analuhaas/MMC/MMC_codes/arm_without_cvb/README.md

# MMC arm - without CVB

## Objectives and context

The goal of this tutorial is to test a MMC stack built with TWIST boards operation with open-loop control using NLM modulation strategy without CVB. For that, we use the two circuit structure below. $R_{dec}$ resistance is connected in parallel to the stack for circuit #2 in order to emulate negative currents discharging the modules capacitor.



As in the individual module test, the boards serves as a HB module of the MMC by programming its second leg (LEG2) to be deactivated, having the following circuit. Observe that the HIGH terminals are open (Vhigh to GND).



The NLM modulation consists of attributing levels according to the modulation signal amplitude using the function round such that the level attributed to the modulation signal is the nearest integer and its principle is represented here:



For example, if the modulation signal is 2.6, it is going to be attributed to level 3. For the MMC, the modulation signal is a sinusoidal wave, making that the NLM modulation result is a stepped wave-form as shown:



This stepped wave-form output of the NLM indicates how many modules should be connected in the stack ($N_{\left(u,l\right),p}^{on}$) according to time.

In this code, no Capacitor Voltage Balancing (CVB) algorithm is used and the choice of connected modules is given by a fixed preference order M1 > M2 > M3 > M4 > M5

## Required Hardware list

- 6 TWIST boards with SPIN
- 6 independent DC power supplies of 6 V with minimum 0.5 A
- 1 DC power supply of (48 V, 5 A)
- Protection diode (at least 100 V)
- 2 resistors of 15\ \Omega
- 5 ethernet cables
- PC 64-bits (windows or linux)
- Oscilloscope
- Current probe
- 6 BNC adaptors to differential voltage measurement

## Required Software list

- Git
- Visual Studio Code with PlatformIO

## Get tutorial code from VScode

First, we need to load the Single module test code from the OwnTech example repository version in https://github.com/analuhaas/examples 
1.	In VScode, open the folder where you previously cloned OwnTech’s github.
2.	In platformio.ini file, substitute the owntech_examples variable link by https://github.com/analuhaas/examples.git 
3.	Go to platform.io icon , go to Examples Twist under the Project Tasks tab and click on “MMC arm – no CVB”.



4.	Now you have the good code to execute the tutorial in your VScode.

## Modules hardware setup

Repeat for the 5 modules boards:

5.	Recommended for MMC use: Configure all 5 modules boards to feed the 6 V auxiliary input externally with feeder completely disconnected from the electrical circuit of the board.

- Connect an External Auxiliary DC Power Supply to the TWIST via the 6 V and DGND PINs. Make sure the External Auxiliary DC Power Supply is configured to deliver 6 V with limiting current above 0.5 A. Make sure this power supply OUTPUT IS OFF.



- Open the jumper JP5001 of the board by cutting the jumper connections using a cutter with an appropriate camera to see the area



6.	If not done yet: Test the module using the [low-frequency](https://github.com/analuhaas/MMC/blob/tutorials_updates/MMC_documentation/module_LF_test_tutorial.md) and [high-frequency](https://github.com/analuhaas/MMC/blob/tutorials_updates/MMC_documentation/module_HF_test_tutorial.md) tests.

## Stack Hardware setup

7.	Connect the boards in series using VLOW1 and GND terminals to form an MMC stack using banana cables (figure below).
8.	Connect to each module an External Auxiliary DC Power Supply to the TWIST via the 6 V and DGND PINs. Make sure the External Auxiliary DC Power Supplies are configured to deliver 6 V with limiting current above 0.5 A. Make sure these power supplies OUTPUT IS OFF (figure below).
9.	Connect the boards using ethernet cables as in the image (figure below).
10.	Connect the stack to the main DC power supply, R and Rdec resistances and diode (figure below).

!!! If using circuit#1, remove Rdec from the circuit. If using circuit #2, circuit exactly as in the image.



11.	Connect the voltage and current measurements with the oscilloscope (figure below). 



After making the connections and connecting the PC to the central controller board with the USB-C cable, you should have something like this:

stack_test_hardware_ready

12.	Configure your Oscilloscope with PicoScope (tutorial using PicoScope 4444)

a.	Make sure it acquires the following measurements:

i.	Modules capacitor voltages (Vhigh to GND).

ii.	Stack current.

iii.	Stack voltage.

b.	Use a 10 s/div configuration with sampling interval around 1 µs (x5 smaller than critical task period)



c.	Configure it to trigger when the stack voltage rises up to 2 V.



## Executing the tutorial Stack test

13.	Get the correct test code using “MMC arm – no CVB”  button.
14.	Optional: Change the test parameters to have a more specific test:

  a.	In code: NLM frequency, number of modules.

  b.	In circuit: Number of modules, resistance values (to reduce or increase current), DC supply voltage.

15.	Repeat to all 5 module boards M1, M2, M3, M4, M5:
  
  a.	Connect the board to the PC via a USB-C cable.
  
  b.	Build  and Upload  the code main.cpp into the board.
  
  c.	Open the serial monitor and copy the board ID to the identification list in the code according to its function in the stack

```
  /* -------------- BOARD IDENTIFICATION ----------------------- */

  constexpr uint32_t UID_MMC_LEAD_BOARD = 0x002B002A;
  
  constexpr uint32_t UID_MMC_SM1_BOARD = 0x00330054;
  
  constexpr uint32_t UID_MMC_SM2_BOARD = 0x0033004B;
  
  constexpr uint32_t UID_MMC_SM3_BOARD = 0x00330049;
  
  constexpr uint32_t UID_MMC_SM4_BOARD = 0x0033004C;
  
  constexpr uint32_t UID_MMC_SM5_BOARD = 0x0031001B;
  
  constexpr uint32_t UID_MMC_SM6_BOARD = 0x11118888;
  
  constexpr uint32_t UID_MMC_SM7_BOARD = 0x11119999;
  
  constexpr uint32_t UID_MMC_SM8_BOARD = 0x1111AAA0;
  
  constexpr uint32_t UID_MMC_SM9_BOARD = 0x1111BBB1;
  
  constexpr uint32_t UID_MMC_SM10_BOARD = 0x1111CCC2;
```

  d.	Do again: Build  and Upload  the code main.cpp into the board.

16. Build  and Upload  the code main.cpp into the Central Controller board.
17. Make sure all modules External Auxiliary DC Power Supply are configured to deliver 6 V with limiting current above 0.5 A. TURN ON the External Auxiliary DC Power Supplies output.
18. After the capacitor voltages comes back to 0, TURN ON the main power supply $u_{dc}$.
19. After the modules are charged with stable voltages more and less at the same level, click “p” to start stack operation with NLM (with or without CVB).
20. After 20 s, TURN OFF the main power supply $u_{dc}$.
21. Click “i” to stop stack operation and put all boards in IDLE mode (blocked state).
22. TURN OFF all 6V External Auxiliary DC Power Supplies.

## Expected results

If you perform the stack test without CVB using circuit#1 at 50 Hz, you should expect an experimental result like this:



If you perform the stack test without CVB using circuit#2 at 50 Hz, you should expect an experimental result like this:
