analuhaas/MMC/MMC_models/Stack/TWIST_based/CVB_modified/README_Simulink_MMC_Stack_TWIST_model_CVBmodifiedtest.md

# MMC stack test simulation with open-loop control using modified CVB algorithm in Simulink with TWIST-based MMC module model

## Context

In this simulation we reproduce the experimental test of a MMC stack with 5 modules. The simulation can be either done using circuit 1 or circuit 2 represented in the figure. In circuit#2, $R_{dec}$ resistance is connected in parallel to the module in order to emulate negative currents discharging the module capacitor.



In experiments, a TWIST board is used as a HB module of the MMC by programming its second leg (LEG2) to be deactivated, having the following circuit. Observe that the HIGH terminals are open (Vhigh to GND). This is reproduced in Simulink using the TWIST board model.



The test consists of using NLM modulation to connect/disconnect modules in order to generate close to sinusoidal stack voltage with a DC component of half the amplitude.

The NLM modulation consists of attributing levels according to the modulation signal amplitude using the function round such that the level attributed to the modulation signal is the nearest integer and its principle is represented here:



For example, if the modulation signal is 2.6, it is going to be attributed to level 3. For the MMC, the modulation signal is a sinusoidal wave, making that the NLM modulation result is a stepped wave-form as shown:



This stepped wave-form output of the NLM indicates how many modules should be connected in the arm ($N_{\left(u,l\right),p}^{on}$) according to time.

In this simulation, the modulation is followed by a Capacitor Voltage Balancing (CVB) algorithm that chooses which modules to connect in order to have equilibrated voltage between all modules. The CVB algorithm makes is choice according to measured capacitor voltages and arm current as described in the algorithm schematic:

CVB_modified_logic

This algorithm is modified from the original CVB simulation to only connect/disconnect $\Delta N_{on}$ modules at a time to reduce oscillations in the generated stack voltage.

It then generates the command to connect or disconnect the modules by setting the gate command signals ($g_{\left(u,l\right),p}^{M1}$, $g_{\left(u,l\right),p}^{M2}$,..., $g_{\left(u,l\right),p}^{MN}$), to 1 (module connected) or 0 (module disconnected). The complete schematic of the open-loop control implemented:



## Simulink Circuit

The Simulink circuit of MMC_stack_openloop_NLM_CVBmodified_twist_HAAS_20260219.slx represents the experimental test circuit. Extra capacitances can be added to the module via Vhigh terminals of the modules such as done experimentally.



Inside the module block, the TWIST board model is used as programmed like a Half-Bridge (HB) module.



Inside the control, the NLM modulation is generated using:



And the CVB algorithm is composed by first a sorting block (generates the order of the modules with ascending capacitor voltage and the measured current sign) and the algorithm itself (decides the modules to connect). The algorithm is only executed if the number of connected modules demanded by the modulation changes.



## Inputs

The simulation can be configured using the following inputs on the script_MMC_stack_openloop_NLM_CVBmodified_twist_HAAS_20260219.m file:

- Inputs for Twist configuration

```
data_save = false; % true : save data in a .mat file the following data
power_losses = false; % true : takes into account power losses from the MOSFETs / false : no power losses
isInterleaved = false; % true : 180° phase shift between leg 1 and leg 2 / false : 0° phase shift
isC1low1Active = false; % true : Q5 is closed / false : Q5 is open
isC2low1Active = false; % true : Q6 is closed / false : Q6 is open
is6VExternallySupplied = false; % true : 6 V external supply is used to supply auxiliary circuits / false : feeder is used to supply auxiliary circuits
isFeederJumperOpen = false; % true : feeder disconnected from the board circuit / false : feeder can be used
```

- Inputs for simulation configuration

```
latest_sim_name = 'MMC_stack_openloop_NLM_CVB_twist_HAAS_20260219.slx'; % Simulink simulation to execute
latest_test_parameters = "param_stack_sim_HAAS_20260219.m"; % Circuit parameters (udc, R, Rdec, etc...)
latest_twist_parameters = "twist_parameters.m"; % TWIST parameters (specifications from TWIST KICAD or obtained experimentally)
sim_time = 1; % [s] Overall simulation time
t_init_sim = -0.01; % [s] Simulation start time
Ts = 1e-6; % [s] Simulation sample period
```

- Inputs for test sequence configuration

```
time_charge = 0.2; % [s] Modules capacitors charging phase duration
time_decharge = 0.8; % [s] Start of modules discharge (VDC = 0V turned off)
```

## Outputs

The simulation results can be observed via the scope area or one can plot externally the results by using the simulation output variables:

```
out.i_u : stores stack current i_u
out.vm_u : stores the stack voltage
out.vc_1 : stores module M1 capacitor voltage vc_M1
out.vc_2 : stores module M2 capacitor voltage vc_M2
out.vc_3 : stores module M3 capacitor voltage vc_M3
out.vc_4 : stores module M4 capacitor voltage vc_M4
out.vc_5 : stores module M1 capacitor voltage vc_M5
out.vm_1 : stores module M1 voltage vm_M1
out.vm_2 : stores module M2 voltage vm_M2
out.vm_3 : stores module M3 voltage vm_M3
out.vm_4 : stores module M4 voltage vm_M4
out.vm_5 : stores module M1 voltage vm_M5
out.vd : stores protection diode voltage v_d
out.m_u : stores the sinusoidal open-loop reference for stack voltage (NLM modulation input)
out.N_u : stores the number of connected modules on the stack (NLM modulation output)
out.i_u_M1_meas : stores stack current i_u measured by M1 that is used on the CVB algorithm
```

The outputs are saved if data_save option is true in to "sim_results" folder

## Executing the simulation

1.	Clone this repository or download the "CVB_modified" folder in your PC.
2.	In matlab, go to "CVB_modified" folder.
3.	Open script_MMC_stack_openloop_NLM_CVBmodified_twist_HAAS_20260219.m file.
4.	Configure your simulation using the script inputs.
5.	Save and run script_MMC_stack_openloop_NLM_CVBmodified_twist_HAAS_20260219.m.

The simulink simulation window will appear and simulation will start

6.	Observe the results via scope our by plotting the saved outputs
