analuhaas/MMC/MMC_documentation/figures/exp_phase_circuit4_D095.png

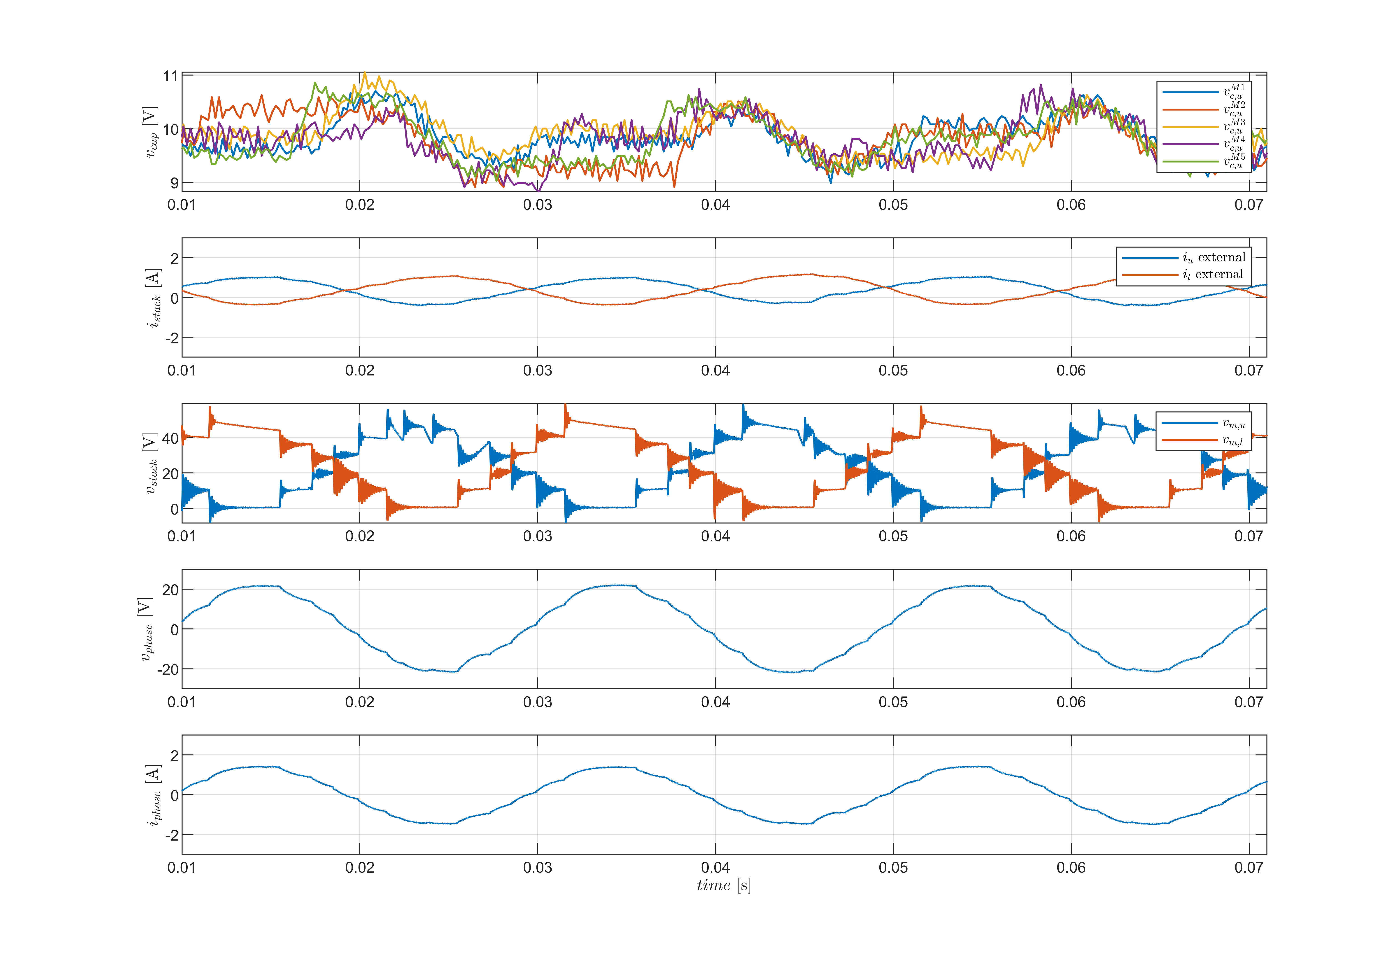
MMC_documentation/figures/exp_phase_circuit4_D095.png
