analuhaas/MMC/MMC_documentation/figures/ID_list.png

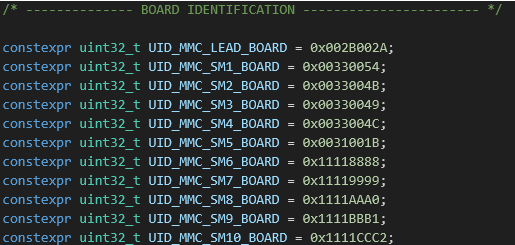
MMC_documentation/figures/ID_list.png
