analuhaas/MMC/MMC_models/Educational prototype/Phase/Sim_NLM_discentralized/figures/sim_communication.png

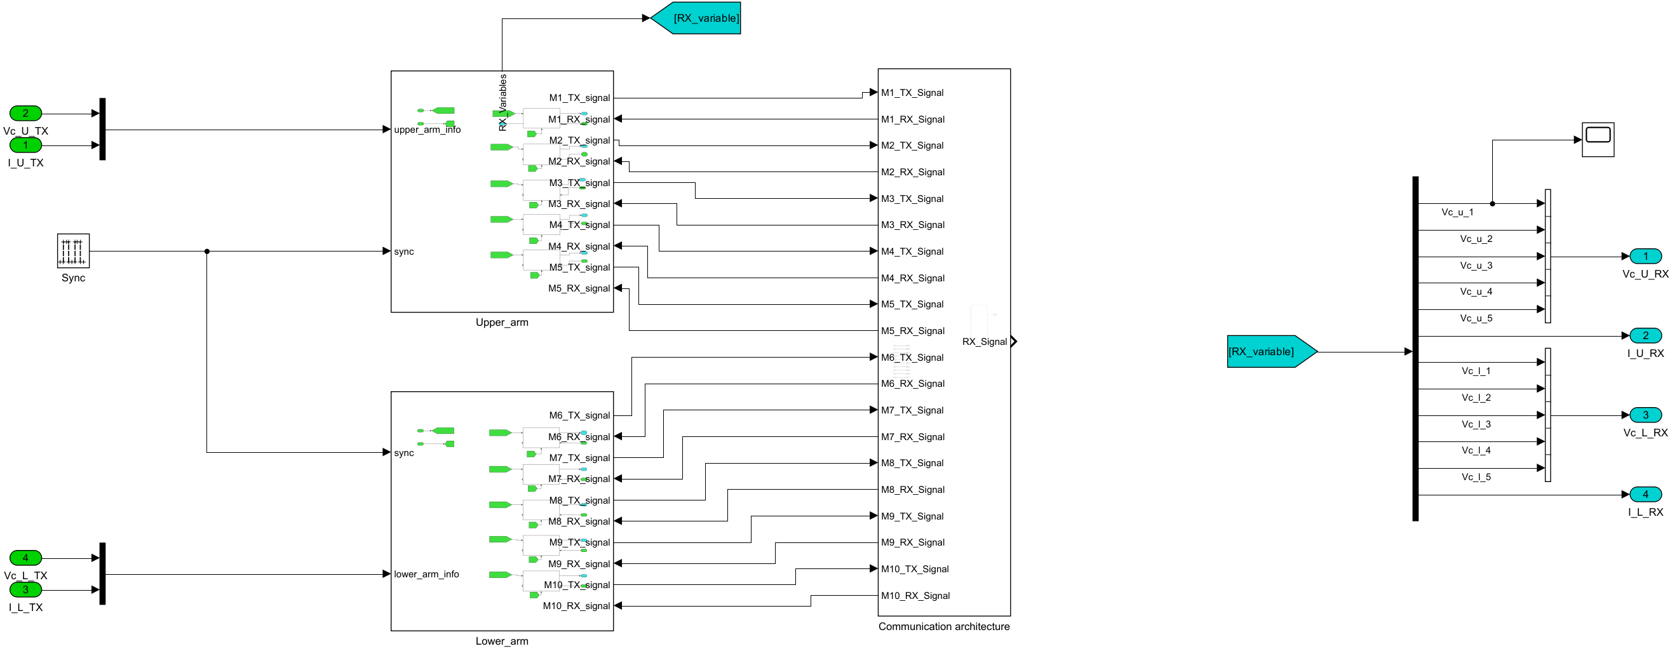
MMC_models/Educational prototype/Phase/Sim_NLM_discentralized/figures/sim_communication.png
