analuhaas/MMC/MMC_models/Educational prototype/Phase/Sim_NLM_discentralized/figures/sim_monitoring.png

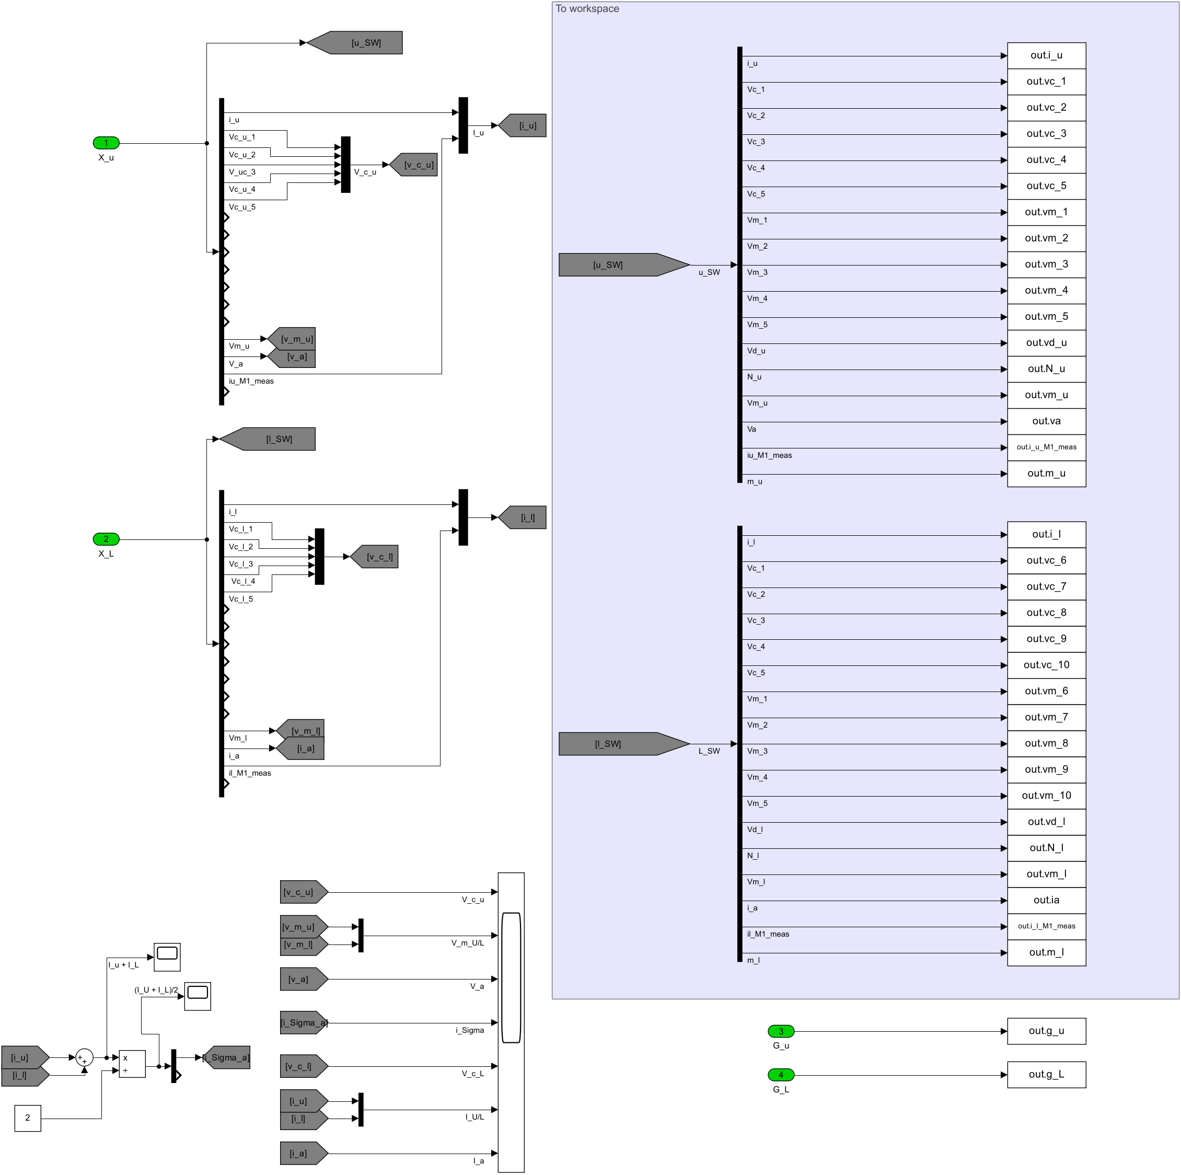
MMC_models/Educational prototype/Phase/Sim_NLM_discentralized/figures/sim_monitoring.png
