analuhaas/MMC/MMC_models/Educational prototype/Phase/Sim_PWM_consensus/figures/sim_top.png

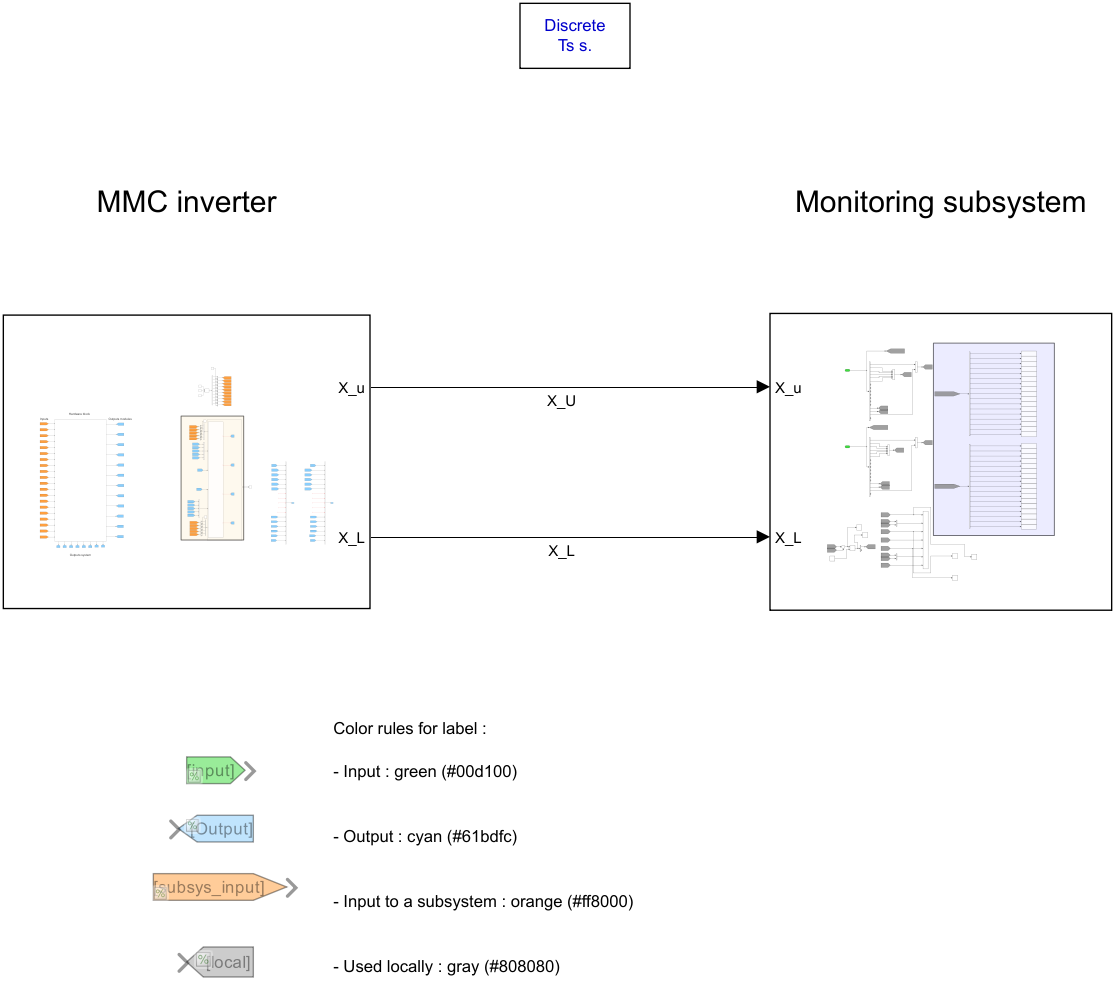
MMC_models/Educational prototype/Phase/Sim_PWM_consensus/figures/sim_top.png
