analuhaas/MMC/MMC_documentation/Prototype tutorials/KiCad_module_capacitor/Condensateur_Ana251211/Composants/Capa/E-SNAP-IN_D300_L250__VSN_SLEEVE_STRUCTURE/E-SNAP-IN_D30_L25__VSN_SLEEVE_STRUCTURE.stp

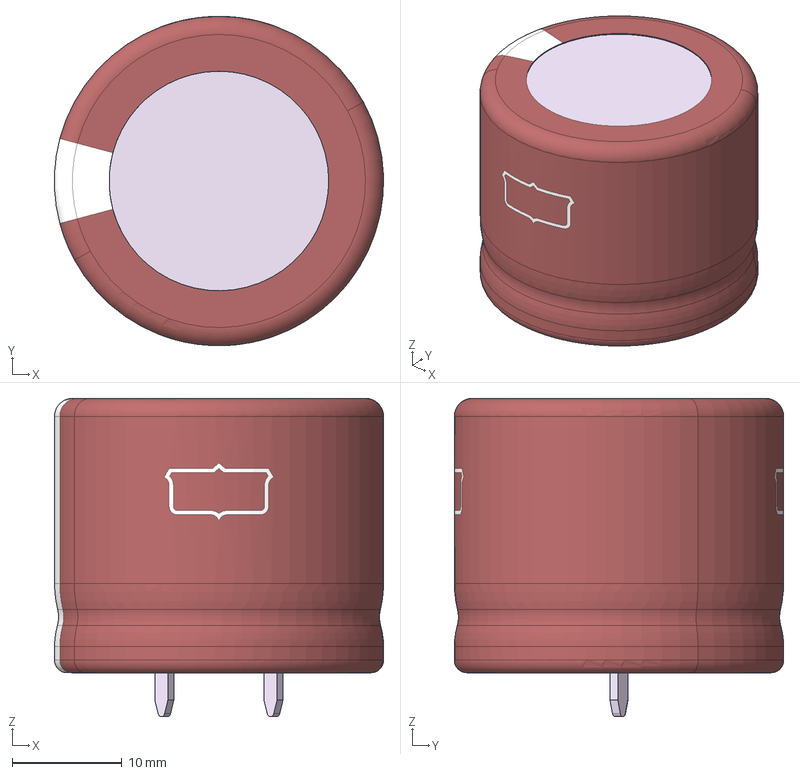
[picture p34: CAD file, 2026-10-09]
MMC_documentation/Prototype tutorials/KiCad_module_capacitor/Condensateur_Ana251211/Composants/Capa/E-SNAP-IN_D300_L250__VSN_SLEEVE_STRUCTURE/E-SNAP-IN_D30_L25__VSN_SLEEVE_STRUCTURE.stp
30.0 x 30.0 x 29.0 mm
E-SNAP-IN_D30_L25_ELEMENT
E-SNAP-IN_VS_TERMINAL-
E-SNAP-IN_VS_TERMINAL+
