analuhaas/MMC/MMC_documentation/Prototype tutorials/KiCad_module_capacitor/Condensateur_Ana251211/Composants/LIB_ELXS251VSN561MR25S/ELXS251VSN561MR25S/3D/ELXS251VSN561MR25S.stp

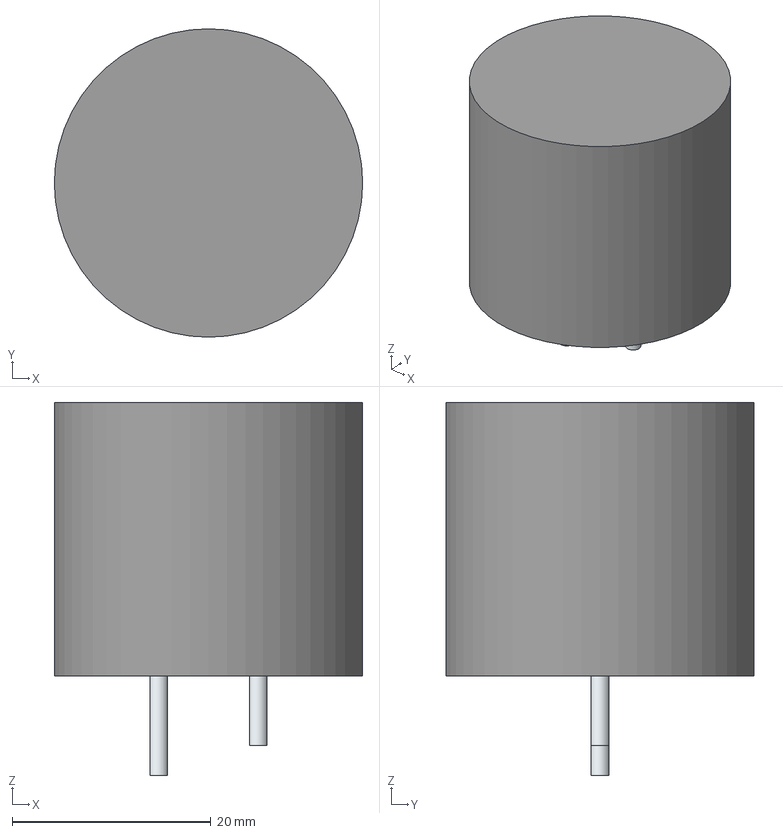
[picture p35: CAD file, 2026-10-09]
MMC_documentation/Prototype tutorials/KiCad_module_capacitor/Condensateur_Ana251211/Composants/LIB_ELXS251VSN561MR25S/ELXS251VSN561MR25S/3D/ELXS251VSN561MR25S.stp
31.0 x 31.0 x 37.5 mm
SimpleBody
Pin1
Pin2
