analuhaas/MMC/MMC_documentation/Prototype tutorials/KiCad_module_capacitor/Condensateur_Ana251211/Composants/LIB_1715721/1715721/3D/1715721.stp

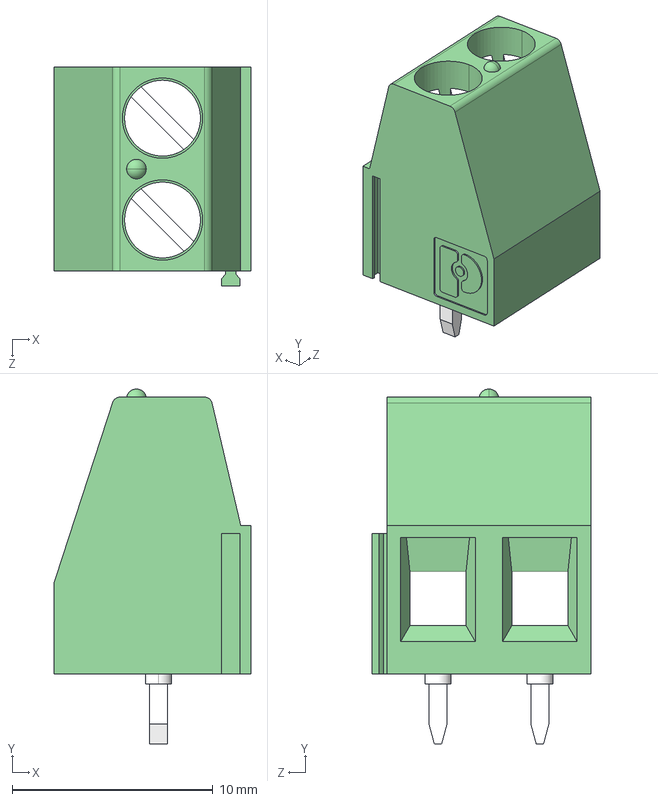
[picture p36: CAD file, 2026-10-09]
MMC_documentation/Prototype tutorials/KiCad_module_capacitor/Condensateur_Ana251211/Composants/LIB_1715721/1715721/3D/1715721.stp
9.80 x 17.7 x 10.9 mm
