analuhaas/MMC/(list of files, cad)

Other CAD files:
MMC_documentation/Prototype tutorials/KiCad_module_capacitor/Condensateur_Ana251211/Composants/Capa/E-SNAP-IN_D300_L250__VSN_SLEEVE_STRUCTURE/E-SNAP-IN_D30_L25__VSN_SLEEVE_STRUCTURE.igs
MMC_documentation/Prototype tutorials/KiCad_module_capacitor/Condensateur_Ana251211/Composants/Capa/E-SNAP-IN_D300_L250__VSN_SLEEVE_STRUCTURE/E-SNAP-IN_D30_L25__VSN_SLEEVE_STRUCTURE.x_t
MMC_documentation/Prototype tutorials/KiCad_module_capacitor/Condensateur_Ana251211/Composants/LIB_1715721/1715721/DEHDL/1715721/chips/chips.prt
MMC_documentation/Prototype tutorials/KiCad_module_capacitor/Condensateur_Ana251211/Composants/LIB_ELXS251VSN561MR25S/ELXS251VSN561MR25S/Allegro/capprd1000w180d3050h2750.psm
MMC_documentation/Prototype tutorials/KiCad_module_capacitor/Condensateur_Ana251211/Composants/LIB_ELXS251VSN561MR25S/ELXS251VSN561MR25S/DEHDL/elxs251vsn561mr25s/chips/chips.prt
