analuhaas/MMC/MMC_models/Module/TWIST_based/HF_test/README_Simulink_MMC_Module_TWIST_model_HFtest.md

# High-frequency test simulation in Simulink with TWIST-based MMC module model

## Context

In this simulation we reproduce the experimental test of a individual MMC module operation in all its states in high frequency. The experimental test has the circuit structure below. $R_{dec}$ resistance is connected in parallel to the module in order to emulate negative currents discharging the module capacitor.



A TWIST board is used as a HB module of the MMC by programming its second leg (LEG2) to be deactivated, having the following circuit. Observe that the HIGH terminals are open (Vhigh to GND).



The test consists of putting the module M1 in Disconnected, Connected and Blocked states according to the correspondence table below:



All these different states are illustrated in the figure below according to the current sign:



The figure below shows the high-frequency test sequence applied to the module with its expected results. Notice that DC power supply is activated at 0s and deactivated at 0.45 s. Notice that the inductor $L_1$ and capacitor $C_{1Low}$ in the low-side of the TWIST module where added to the module representation.



## Simulink Circuit

The Simulink circuit of MMC_1module_twist_HF_20260219.slx represents the experimental test circuit. Inside the Twist power block, the TWIST board is modelled considering its power block + feeder behaviors.



The high-frequency sequence is generated using logic blocks:



## Inputs

The simulation can be configured using the following inputs on the script_MMC_1module_twist_LF_20260219.m file:

- Inputs for Twist configuration

```
data_save = false; % true : save data in a .mat file the following data
power_losses = false; % true : takes into account power losses from the MOSFETs / false : no power losses
isInterleaved = false; % true : 180° phase shift between leg 1 and leg 2 / false : 0° phase shift
isC1low1Active = false; % true : Q5 is closed / false : Q5 is open
isC2low1Active = false; % true : Q6 is closed / false : Q6 is open
is6VExternallySupplied = false; % true : 6 V external supply is used to supply auxiliary circuits / false : feeder is used to supply auxiliary circuits
isFeederJumperOpen = false; % true : feeder disconnected from the board circuit / false : feeder can be used
```

- Inputs for simulation configuration

```
latest_sim_name = 'MMC_1module_twist_LF_20260219.slx'; % Simulink simulation to execute
latest_test_parameters = "test_parameters.m"; % Circuit parameters (udc, R, Rdec, etc...)
latest_twist_parameters = "twist_parameters.m"; % TWIST parameters (specifications from TWIST KICAD or obtained experimentally)
sim_time = 1; % [s] Overall simulation time
t_init_sim = -0.01; % [s] Simulation start time
Ts = 1e-6; % [s] Simulation sample period
```

- Inputs for low-frequency sequence configuration

```
t1 = 0.35; % [s] Sequence time t1 (default 0.35)
t2 = 0.38; % [s] Sequence time t2 (default 0.38)
t3 = 0.8; % [s] Sequence time t3 (default 0.8)
t4 = 0.83; % [s] Sequence time t4 (default 0.83)
Vdc_off_time = 0.45; %[s] Time where VDC = 0V (turned off)
Vdc_on_time = 0; %[s] Time where VDC = 40V (turned on)
```

## Outputs

The simulation results can be observed via the scope area or one can plot externally the results by using the simulation output variables:

```
out.modules : contains module current i_M1, module capacitor voltage Vc_M1 and module voltage Vm_M1
out.bus_dc : contains protection diode voltage v_D, DC current i_dc and DC power supply voltage v_dc
out.modes : contains module state information during sequence execution
```

The outputs are saved if data_save option is true in to "sim_results" folder

## Executing the simulation

1.	Clone this repository or download the "HF_test" folder in your PC.
2.	In matlab, go to "HF_test" folder.
3.	Open script_MMC_1module_twist_HF_20260219.m file.
4.	Configure your simulation using the script inputs.
5.	Save and run script_MMC_1module_twist_HF_20260219.m.

The simulink simulation window will appear and simulation will start

6.	Observe the results via scope our by plotting the saved outputs
