analuhaas/MMC/(list of files, drawings)

Other design files:
MMC_documentation/Prototype tutorials/KiCad_module_capacitor/Condensateur_Ana251211/Composants/LIB_ELXS251VSN561MR25S/ELXS251VSN561MR25S/Altium/CAPPRD1000W180D3050H2750.PcbLib
MMC_documentation/Prototype tutorials/KiCad_module_capacitor/Condensateur_Ana251211/Composants/LIB_ELXS251VSN561MR25S/ELXS251VSN561MR25S/Altium/ELXS251VSN561MR25S.SchLib
