analuhaas/MMC/MMC_documentation/Prototype tutorials/KiCad_module_capacitor/Condensateur_Ana251211/Condensateur_Ana_251210.kicad_pcb

## KiCad design MMC_documentation/Prototype tutorials/KiCad_module_capacitor/Condensateur_Ana251211/Condensateur_Ana_251210.kicad_pcb (2026-10-09)

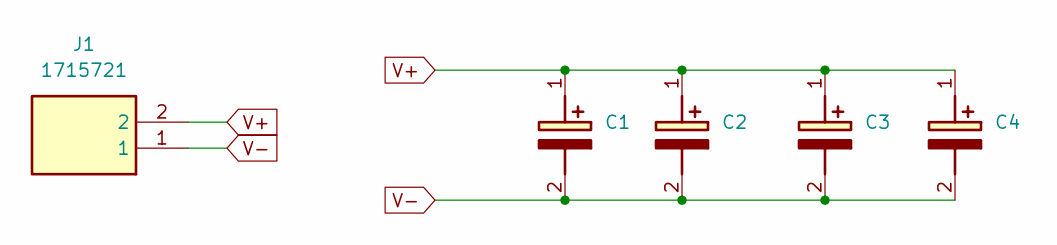
[picture p68: schematic Condensateur_Ana_251210.kicad_sch]

Parts:
C1, C2, C3, C4: ELXS251VSN561MR25S; CAPPRD1000W180D3050H2750; Mouser Part Number 661-ELXS251VSN561MR2
J1: 1715721; Mouser Part Number 651-1715721

Connections:
V+: C1.1 (+), C2.1 (+), C3.1 (+), C4.1 (+), J1.2
V-: C1.2 (-), C2.2 (-), C3.2 (-), C4.2 (-), J1.1

Board: 2 copper layers, 5 parts (0 on the bottom side), 2 nets, no tracks yet.
