analuhaas/MMC/(commit log)

2026-02-19 Added all current module/stack/phase models on GitHub
2026-02-23 Update module_HF_test_tutorial.md adding buttons images
2026-02-23 Update module_LF_test_tutorial.md adding buttons icons
2026-02-23 Update stack_openloop_CVB_test_tutorial.md adding buttons icons
2026-02-23 Update stack_openloop_noCVB_test_tutorial.md adding buttons icons
2026-02-25 Update phase_openloop_CVB_test_tutorial.md added circuits figures and simulation results with circulating current
2026-03-05 Update README_Simulink_MMC_Phase_TWIST_model_circuit1.md with circuits photo
2026-03-05 Update README_Simulink_MMC_Phase_TWIST_model_circuit2.md updates simulink circuit photo
2026-03-05 Update README_Simulink_MMC_Phase_TWIST_model_circuit3.md with simulink circuit photo
2026-03-05 Update README_Simulink_MMC_Phase_TWIST_model_circuit4.md with simulink circuit photo
2026-05-26 Modified phase tutorials markdown to add experimental results and fuses substitutions photos
2026-05-26 Added snippet of calibration to the markdown
2026-05-26 Added instructions to calibrate the board sensors
2026-05-26 Added figures to examplificate the fuses substitution
2026-05-26 Separated into modifications and calibration tutorials
2026-05-26 Added all images of circuit configurations
2026-05-31 Added results to phase tutorial and updated owntech kicad tutorial
2026-06-01 Added tutorial for calibration
2026-06-01 Substituted images of circuits
2026-06-01 Added snippet of the boards IDs
