analuhaas/MMC/(notices)

Notices in the files:
MMC_codes/Educational prototype/stack_with_cvb/main.cpp:
This program is free software: you can redistribute it and/or modify
it under the terms of the GNU Lesser General Public License as published by
the Free Software Foundation, either version 2.1 of the License, or
(at your option) any later version.
